Churro209/Capstone-Project-Repo/Lab_NoteBook/2026/3-1-26-PCB_Design/labnote.md

# Lab Entry – 2026-03-01

## Metadata
- Date: 2026-03-01
- Project: Off Grid Solar Battery Charger
- Board / Rev:
- Scope: Design 4 Layer PCB

## Objective
Design 4 layer PCB such that:
- Solid Ground Plane
- Use Copper Pour to reduce trace impedance where possible
- Seperate high di/dt and sensative measurments

## Setup
<figure>
<image src = "images/Screenshot 2026-03-01 at 10.18.40 AM.png">
<figcaption> Figure 1 - PCB layout</figcaption>
</figure>
<figure>
<image src="images/Screenshot 2026-03-01 at 10.22.36 AM.png">
<figcaption> Figure 2 - PCB Layout </figcaption>
</figure>

## Next Steps
Order parts for the PCB. Verify correct footprints and then order PCB.
