Churro209/Capstone-Project-Repo/Lab_NoteBook/2026/3-1-26-PCB_Design/images/Screenshot 2026-03-01 at 10.18.40 AM.png

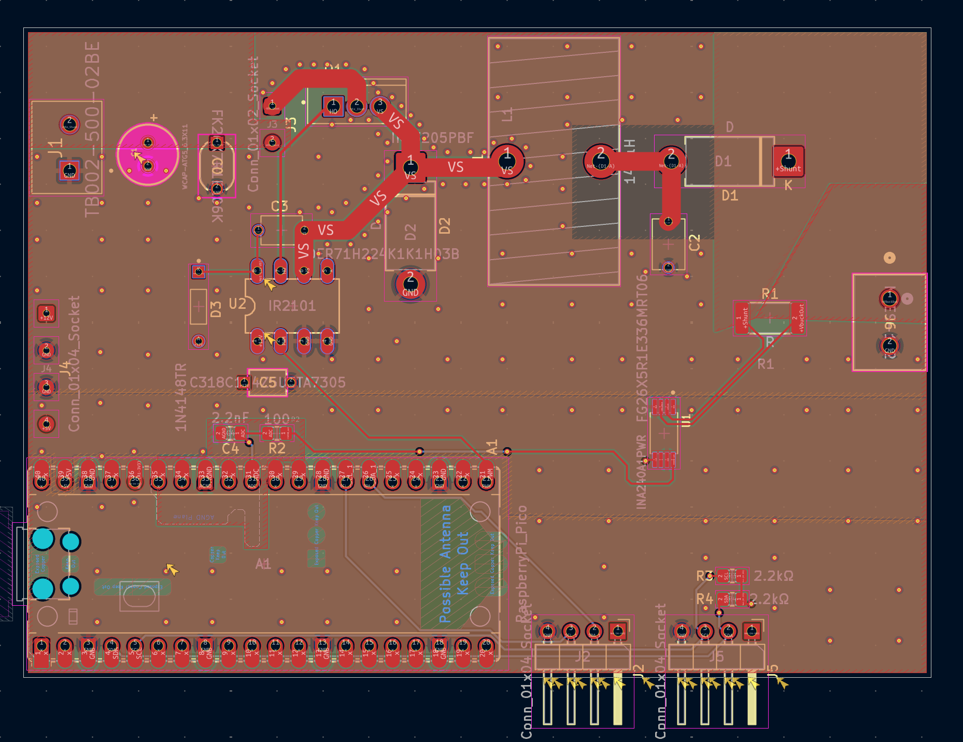
Lab_NoteBook/2026/3-1-26-PCB_Design/images/Screenshot 2026-03-01 at 10.18.40 AM.png
