Churro209/Capstone-Project-Repo/Lab_NoteBook/2026/1-09-2026-Solder-INA219-Breakout-PCB/images/INA219_Breakout.jpeg

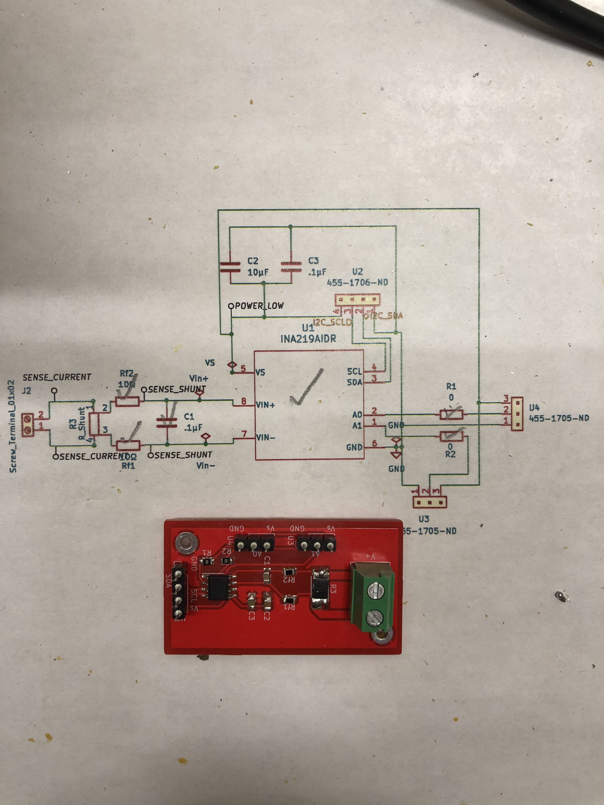
Lab_NoteBook/2026/1-09-2026-Solder-INA219-Breakout-PCB/images/INA219_Breakout.jpeg
