Churro209/Capstone-Project-Repo/Lab_NoteBook/2026/1-11-2026-HILTest-INA219PCB/images/HIL-Test-Result.png

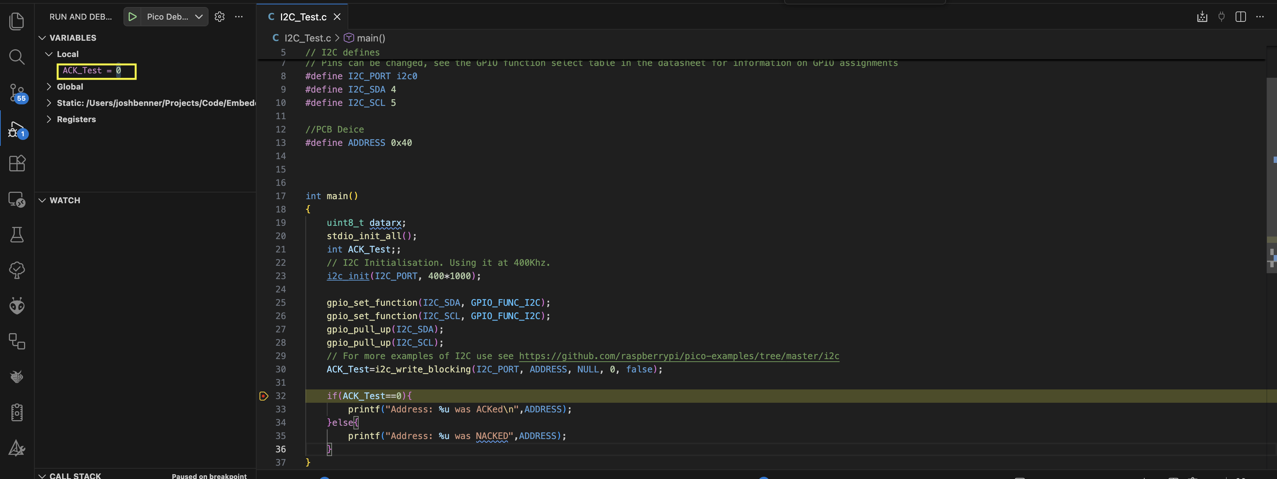
Lab_NoteBook/2026/1-11-2026-HILTest-INA219PCB/images/HIL-Test-Result.png
