Churro209/Capstone-Project-Repo/Ina219_Breakout_PCB/Capstone_Proj.kicad_pcb

## KiCad design Ina219_Breakout_PCB/Capstone_Proj.kicad_pcb (2026-01-07)

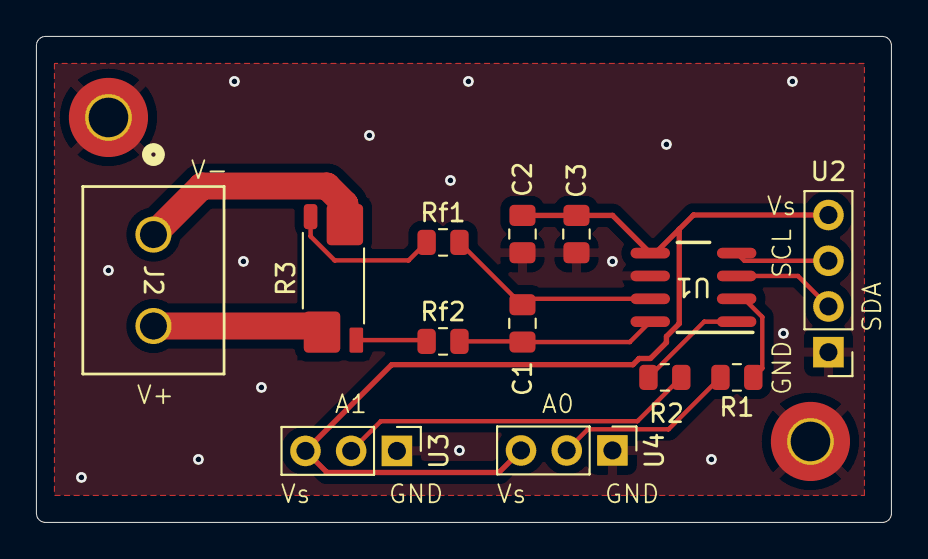
[picture p38: board Capstone_Proj.kicad_pcb from above]

Board: 2 copper layers, 47.5 x 27.0 mm, 13 parts (0 on the bottom side), 14 nets.

Parts:
C1, C3: .1µF; C_0805_2012Metric_Pad1.18x1.45mm_HandSolder
C2: 10µF; C_0805_2012Metric_Pad1.18x1.45mm_HandSolder
J2: Screw_Terminal_01x02; CONN_MBES-152_ALT
R1, R2: 0; R_0805_2012Metric
R3: R_Shunt; R_Shunt_Vishay_WSK2512_6332Metric_T1.19mm
Rf1, Rf2: 10Ω; R_0805_2012Metric
U1: INA219AIDR; D0008A_N
U2: 455-1706-ND; PinHeader_1x04_P2.54mm_Vertical
U3, U4: 455-1705-ND; PinHeader_1x03_P2.54mm_Vertical

Connections:
/I2C_SCL: U1.4 (SCL), U2.3
/I2C_SDA: U1.3 (SDA), U2.2
GND: C2.1, C3.1, U1.6 (GND), U2.1, U3.1, U4.1
unnamed: J2.1, R3.4
unnamed: J2.2, R3.1
unnamed: R1.2, U4.2
unnamed: R2.2, U3.2
unnamed: R3.2, Rf2.1
unnamed: R3.3, Rf1.1
unnamed: R1.1, U1.2 (A0)
unnamed: R2.1, U1.1 (A1)
unnamed: C1.1, Rf2.2, U1.8 (VIN+)
unnamed: C1.2, Rf1.2, U1.7 (VIN-)
unnamed: C2.2, C3.2, U1.5 (VS), U2.4, U3.3, U4.3
