Churro209/Capstone-Project-Repo/(commit log)

2026-01-07 intial commit for files to share
    [Capstone_Proj.kicad_pcb, Capstone_Proj.kicad_sch]
2026-01-10 1/09/2026 lab entry. Soldered INA219 Breakout PCB and verified continuity and no shorts.
2026-01-10 01/09/2026 Lab Entry: Soldered INA219 breakout PCB. Used a multimeter to test for solid connections and shorts. PASSED.
2026-01-12 1/11/2026 INA219 PCB ACK HIL test: PASSED
2026-01-18 INA219 Board 2: HIL test. PASSED
2026-01-25 Research: Gate Drive IC Data sheet & PWM Generation on Raspberry Pi Pico.
2026-01-31 Verify equations and parameter values to generate correct PWM. Use this file when writing the .c file
2026-02-01 Verified functionality of PWM with HIL/SIL tests
2026-02-09 IR2101PBF -HIL test. Repeat with Low side mosfet and smaller load value.
2026-02-12 Proof of concept to prevent shoot through on synchronous buck converter.
2026-02-12 Proof Of concept for PWM high and low side config with shoot through prevention.
2026-02-14 Test gate drive with high and low side mosfets. Will not use.
2026-02-21 HIL test Buck Converter + PWM from Pico + Gate Drive IC. No Feed back
2026-02-21 PCB Re Design
2026-03-01 PCB layout
