Churro209/Capstone-Project-Repo/Lab_NoteBook/2026/1-31-2026-SoftwarePWM/images/75Duty.jpeg

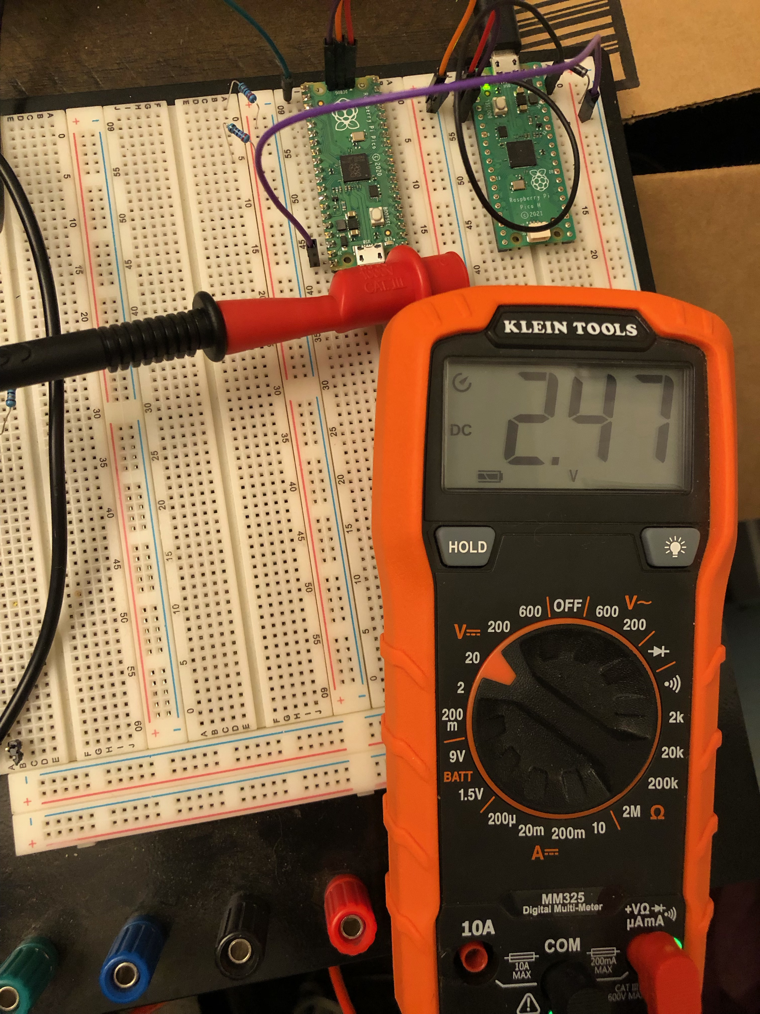
[picture p12: Lab_NoteBook/2026/1-31-2026-SoftwarePWM/images/75Duty.jpeg]
Lab_NoteBook/2026/1-31-2026-SoftwarePWM/images/75Duty.jpeg
