Churro209/Capstone-Project-Repo/Lab_NoteBook/2026/1-31-2026-SoftwarePWM/images/50Duty.jpeg

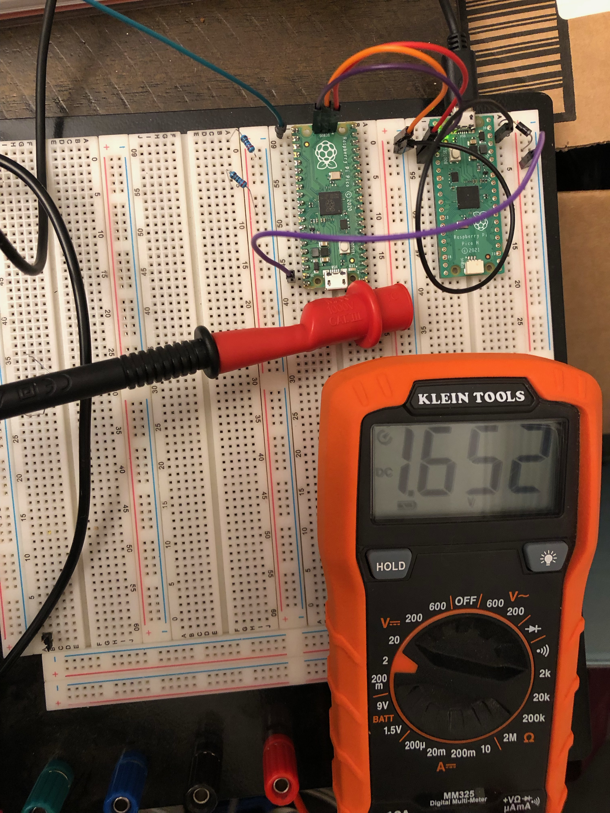
[picture p13: Lab_NoteBook/2026/1-31-2026-SoftwarePWM/images/50Duty.jpeg]
Lab_NoteBook/2026/1-31-2026-SoftwarePWM/images/50Duty.jpeg
